luk4n23/Kratka-do-lazienki/kratka-naroznik_gr1.5mm_1szt_DC01.pdf

## kratka-naroznik_gr1.5mm_1szt_DC01.dxf

rozwinięcie 309.57 × 2430 mm | DC01 1,5 mm | 1 szt. | masa 6.76 kg | gabaryt po gięciu 140 × 90 × 2430 mm

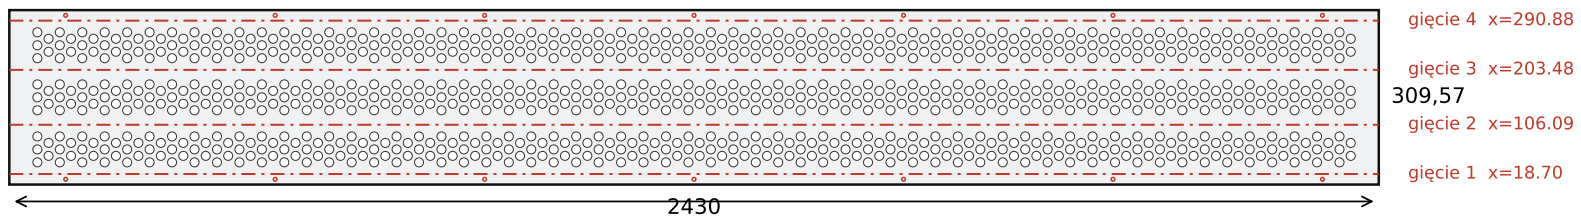
[picture p1: figure]
gięcie 1; gięcie 2; gięcie 3; gięcie 4

Rozwinięcie (pokazane w poziomie — detal jest pionowy). Czerwona kreska-kropka = linia gięcia, w DXF jej NIE MA.

Detal perforacji (1:1)
JEDEN ELEMENT GIĘTY — bez spawania i bez nitowania.

KOLEJNOŚĆ, KIERUNEK I KĄT GIĘCIA

1. kołnierz A | linia x = | 18.70 mm, | kąt 90°, | w dół

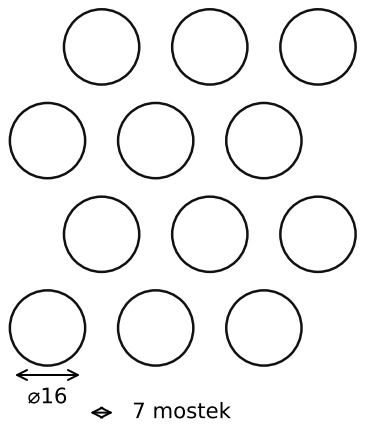
[picture p2: figure]
7 mostek

2. kołnierz B | linia x = | 290.88 mm, | kąt 90°, | w dół
3. naroże lewe | linia x = | 106.09 mm, | kąt 90°, | w górę
4. naroże prawe linia x = | 203.48 mm, | kąt 90°, | w górę
Najpierw oba kołnierze (1, 2) na płasko, potem oba naroża (3, 4).

Kołnierze gną się w przeciwną stronę niż naroża.

R wewnętrzny 1,5 mm · K = 0,44 · odcięcie na gięcie 2,607 mm.

PERFORACJA
Otwory ⌀16, podziałka 23 mm, układ przestawny 60°, mostek 7 mm (4,7 × grubości).

885 otworów, powierzchnia otwarta 38 %. Perforacja kończy się 12,7 mm przed narożami.

OTWORY MONTAŻOWE

2 × 7 otworów ⌀6,5 w kołnierzach, rozstaw 371,7 mm, pierwszy 100 mm od dołu.

CIĘCIE

50,2 m konturu, 900 przebić. Warstwa CIECIE (jedyna), wszystkie kontury zamknięte.

WYKOŃCZENIE

Malowanie proszkowe na biało RAL 9003.
