luk4n23/Kratka-do-lazienki/kratka-naroznik_rysunek-techniczny_DC01.pdf

## 1 ROZWINIĘCIE BLACHY — tak wygląda detal po wycięciu, przed gięciem skala 1:10

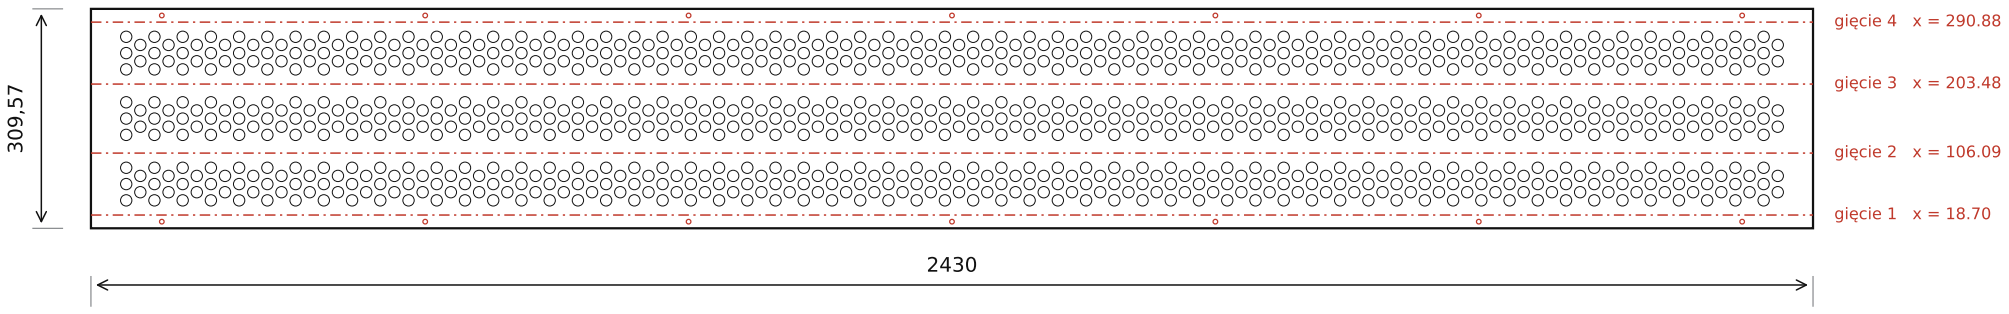
[picture p3: figure]
gięcie 1 x = 18.70; gięcie 2 x = 106.09; gięcie 3 x = 203.48; gięcie 4 x = 290.88

Czerwona linia kreska-kropka = linia gięcia. W pliku DXF jej nie ma — DXF zawiera wyłącznie kontury do wycięcia.
Czerwone okręgi = otwory montażowe ⌀6,5 w kołnierzach. Warstwa cięcia w DXF: CIECIE (jedyna), wszystkie kontury zamknięte.

## 2 PRZEKRÓJ PO GIĘCIU — widok z góry skala 1:2

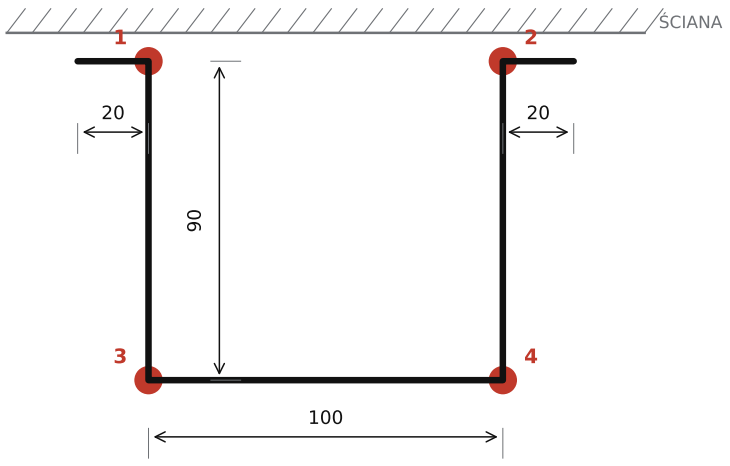
[picture p4: figure]
ŚCIANA

LICO — strona widoczna od strony pomieszczenia

Cztery gięcia po 90°, promień wewnętrzny R1,5 mm. Kołnierze (1, 2) gną się w przeciwną stronę niż naroża (3, 4). Gabaryt po gięciu: 140 × 90 × 2430 mm (szer. × głęb. × wys.).

## 3 DETAL PERFORACJI skala 1:1

⌀16

7 mostek

23

23

Otwory okrągłe ⌀16 mm, podziałka 23 mm, układ przestawny 60°.
Mostek 7 mm = 4,7 × grubości blachy. Powierzchnia otwarta 38 %.
Perforacja kończy się 12,7 mm przed każdym narożem — gięcie jej nie deformuje.

## 4 KOLEJNOŚĆ GIĘCIA

nr | element | linia x [mm] | kąt | kierunek
1 | kołnierz A | 18.70 | 90° | w dół
2 | kołnierz B | 290.88 | 90° | w dół
3 | naroże lewe | 106.09 | 90° | w górę
4 | naroże prawe | 203.48 | 90° | w górę

Najpierw oba kołnierze (1, 2) — na płasko. Dopiero potem oba naroża (3, 4).

R wewnętrzny 1,5 mm · współczynnik K = 0,44 · odcięcie na gięcie 2,607 mm.

Przy innym K-factorze prasy rozwinięcie trzeba przeliczyć.

## 5 UWAGI

Jeden element gięty — bez spawania i bez nitowania.

Materiał: DC01 (stal głęboko tłoczna), grubość 1,5 mm.

Wykończenie: odgratowanie krawędzi, odtłuszczenie, malowanie

proszkowe na biało RAL 9003 — również wewnątrz otworów.

Mocowanie: 2 × 7 otworów ⌀6,5 w kołnierzach przyściennych,

rozstaw 371,7 mm, pierwszy 100 mm od dołu.

Cięcie laserowe: 50,2 m konturu, 900 przebić na sztukę.

Z arkusza 1250 × 2500 wychodzą 3 szt., z 1500 × 3000 — 4 szt.

Prasa krawędziowa musi mieć długość roboczą min. 2430 mm.

ULAMEX · Zawada 144 · 97-200 Tomaszów Mazowiecki

## KRATKA NAROŻNA — OBUDOWA PIONU INSTALACYJNEGO

Materiał

DC01, gr. 1,5 mm

Wykończenie

malowanie proszkowe RAL 9003

Masa
6.76 kg / szt.

Nr rysunku
ULX-2430-DC01-01

Ilość / jednostki

1 szt. · wymiary w mm

Tolerancje ogólne / data
ISO 2768-mK · 2026-11-02
