luk4n23/Kratka-do-lazienki/kratka-naroznik_gr1.5mm_1szt_DC01.dxf

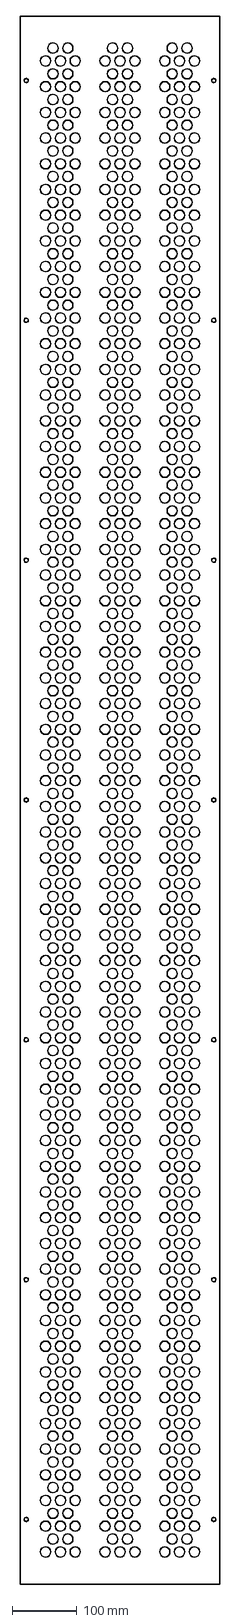
[picture p5: CAD file, 2026-11-02]
kratka-naroznik_gr1.5mm_1szt_DC01.dxf
309.6 x 2430.0 mm
